MaryTennyson/Embaxus_Steno_Keyboard/docs/schematic.pdf

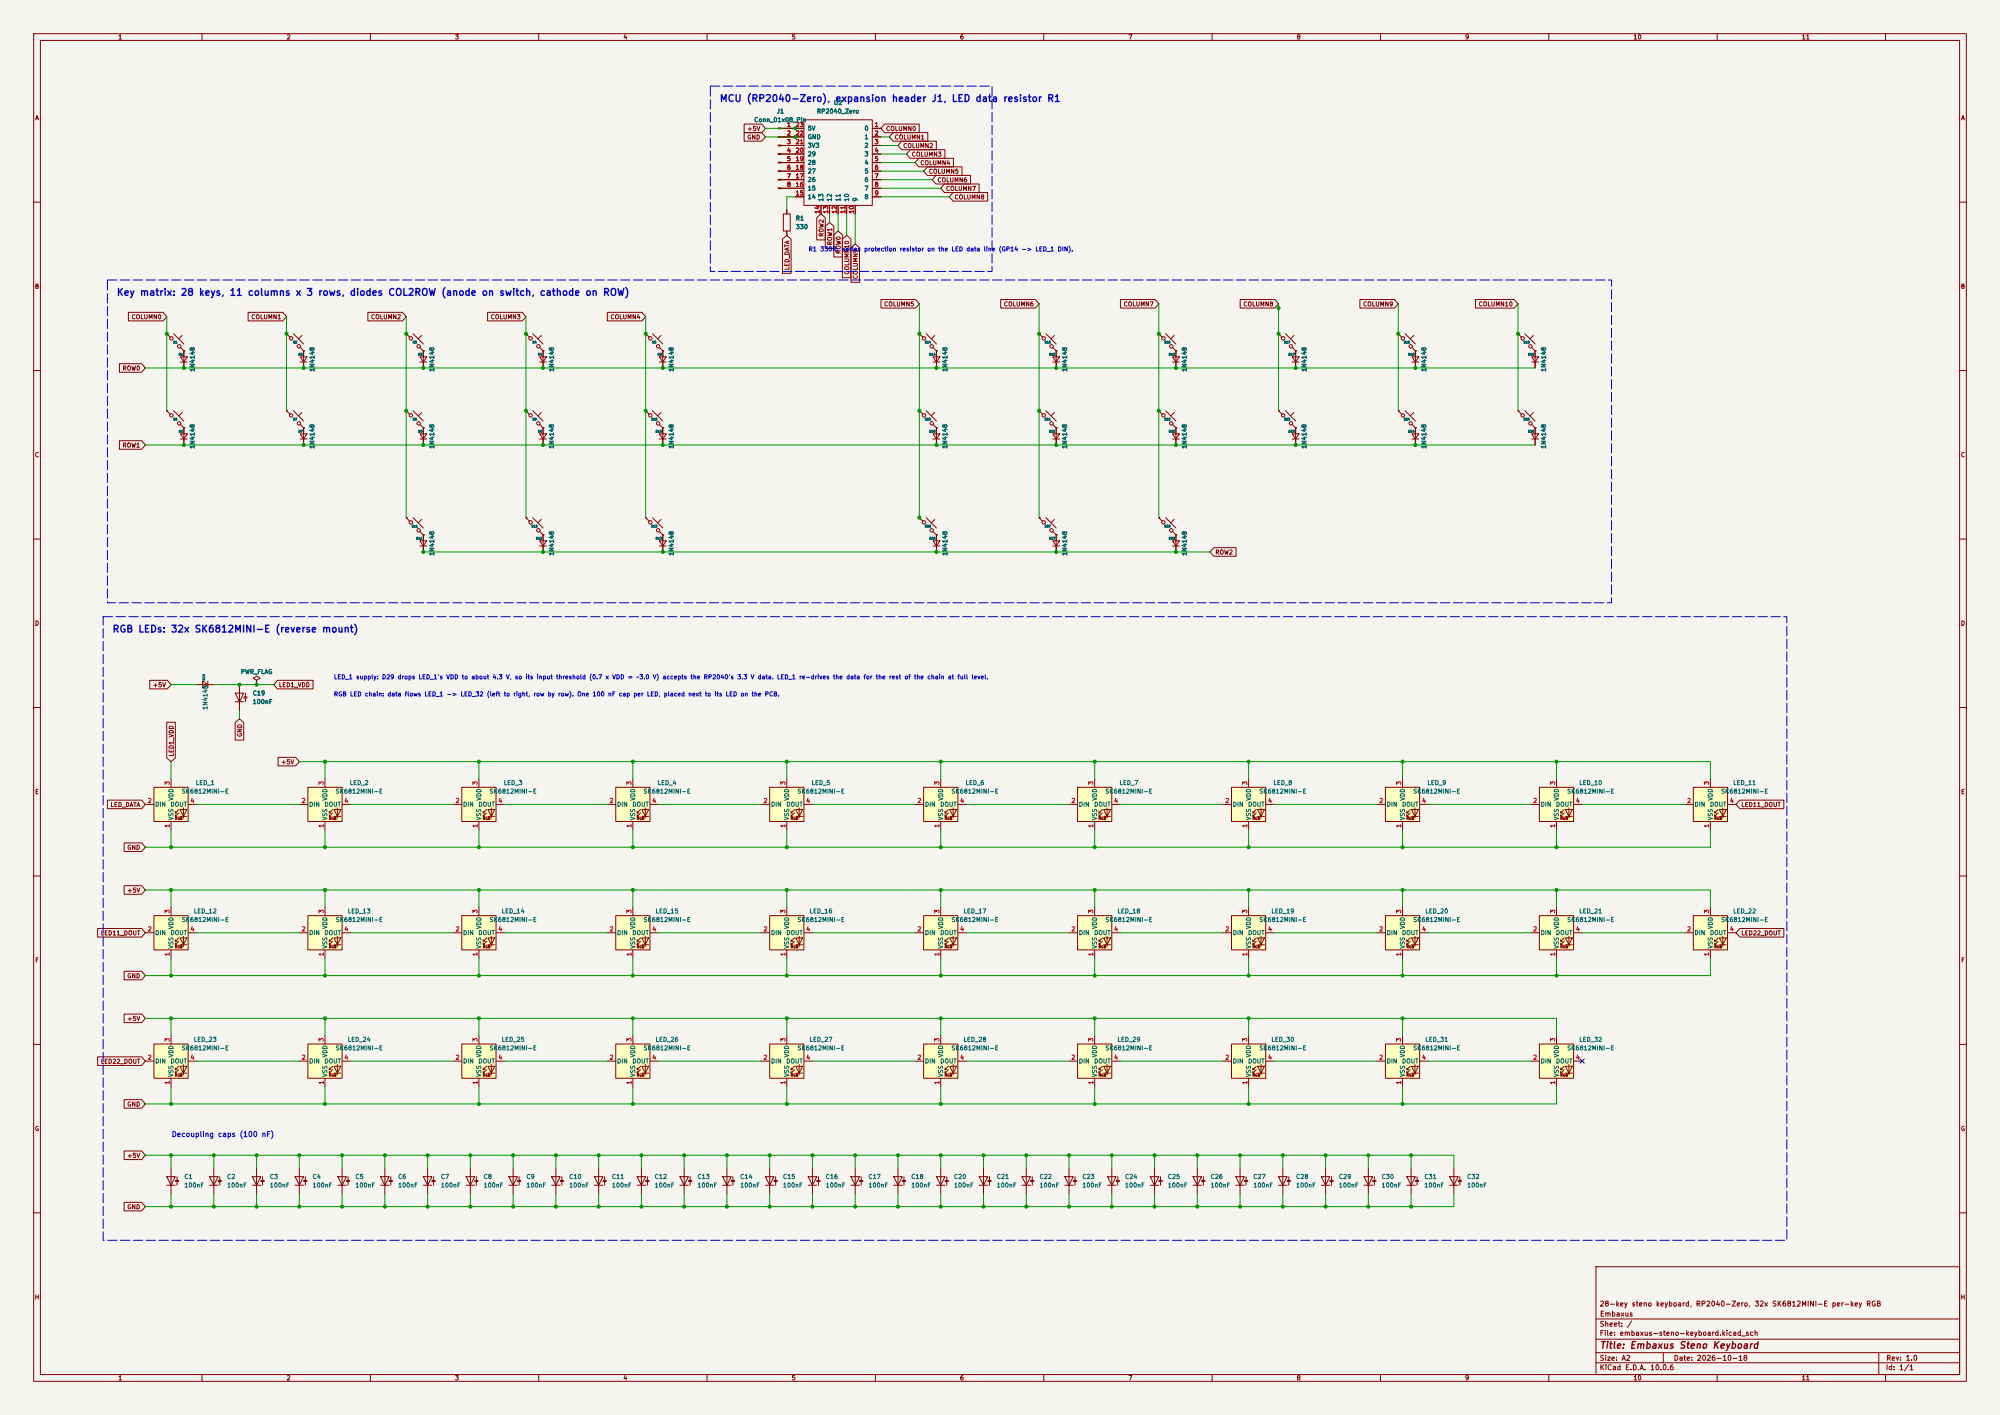
[picture p3: page 1]

COLUMN1 Key matrix: 28 keys, 11 columns x 3 rows, diodes COL2ROW (anode on switch, cathode on ROW)

R1 330R: series protection resistor on the LED data line (GP14 -> LED_1 DIN).

RGB LEDs: 32x SK6812MINI-E (reverse mount)

LED_1 supply: D29 drops LED_1's VDD to about 4.3 V, so its input threshold (0.7 x VDD = ~3.0 V) accepts the RP2040's 3.3 V data. LED_1 re-drives the data for the rest of the chain at full level. RGB LED chain: data flows LED_1 -> LED_32 (left to right, row by row). One 100 nF cap per LED, placed next to its LED on the PCB.

28-key steno keyboard, RP2040-Zero, 32x SK6812MINI-E per-key RGB
Embaxus
Sheet: /
File: embaxus-steno-keyboard.kicad_sch
Title: Embaxus Steno Keyboard

Size: A2 | Rev: 1.0
KiCad E.D.A. 10.0.6 | Id: 1/1
