MaryTennyson/Embaxus_Steno_Keyboard/hardware/embaxus-steno-keyboard.kicad_pcb

## KiCad design hardware/embaxus-steno-keyboard.kicad_pcb (2026-10-19)

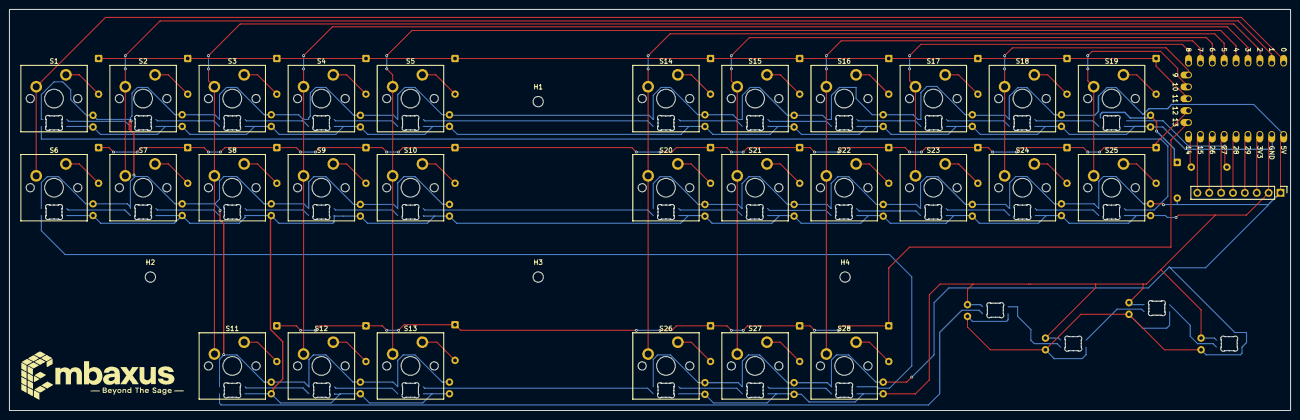
[picture p4: board embaxus-steno-keyboard.kicad_pcb from above]

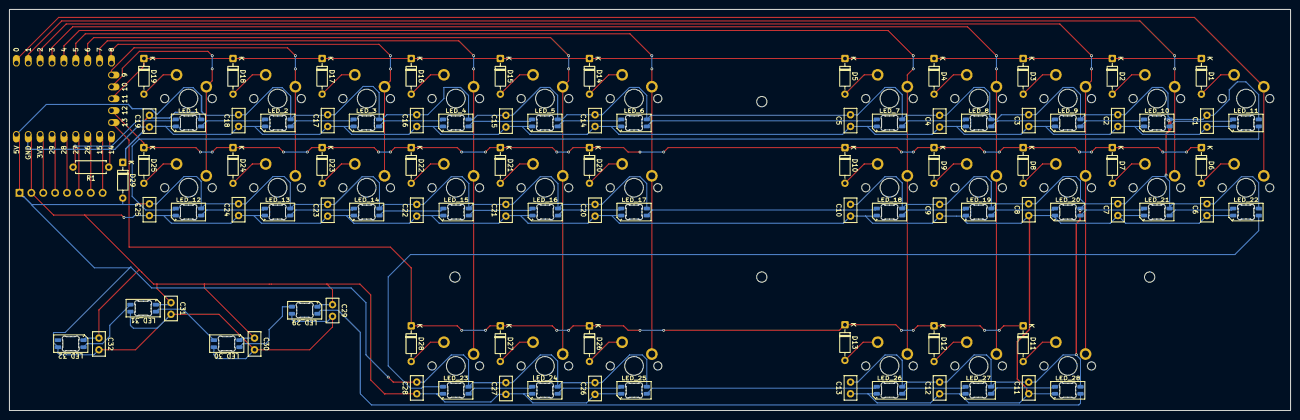
[picture p5: board embaxus-steno-keyboard.kicad_pcb from below]

Board: 2 copper layers, 273.8 x 85.7 mm, 128 parts (95 on the bottom side), 84 nets.

Parts:
C1, C2, C3, C4, C5, C6, C7, C8, C9, C10, C11, C12, C13, C14, C15, C16, C17, C18, C19, C20, C21, C22, C23, C24, C25, C26, C27, C28, C29, C30, C31, C32: 100nF; C_Disc_D5.0mm_W2.5mm_P2.50mm
D1, D2, D3, D4, D5, D6, D7, D8, D9, D10, D11, D12, D13, D14, D15, D16, D17, D18, D19, D20, D21, D22, D23, D24, D25, D26, D27, D28, D29: 1N4148; D_DO-35_SOD27_P7.62mm_Horizontal
H1, H2: M2; MountingHole_2.2mm_M2
H3: M3; MountingHole_2.2mm_M2
H4: M4; MountingHole_2.2mm_M2
J1: Conn_01x08_Pin; PinHeader_1x08_P2.54mm_Vertical
LED_1, LED_2, LED_3, LED_4, LED_5, LED_6, LED_7, LED_8, LED_9, LED_10, LED_11, LED_12, LED_13, LED_14, LED_15, LED_16, LED_17, LED_18, LED_19, LED_20, LED_21, LED_22, LED_23, LED_24, LED_25, LED_26, LED_27, LED_28, LED_29, LED_30, LED_31, LED_32: SK6812MINI-E; LED_SK6812MINI-E_3.2x2.8mm_P1.5mm_ReverseMount
R1: 330; R_Axial_DIN0207_L6.3mm_D2.5mm_P7.62mm_Horizontal
S1, S2, S3, S4, S5, S6, S7, S8, S9, S10, S11, S12, S13, S14, S15, S16, S17, S18, S19, S20, S21, S22, S23, S24, S25, S26, S27, S28: MX_PCB_1.00u
U2: RP2040_Zero

Connections:
+5V: C1.2 (A), C2.2 (A), C3.2 (A), C4.2 (A), C5.2 (A), C6.2 (A), C7.2 (A), C8.2 (A), C9.2 (A), C10.2 (A), C11.2 (A), C12.2 (A), C13.2 (A), C14.2 (A), C15.2 (A), C16.2 (A), C17.2 (A), C18.2 (A), C20.2 (A), C21.2 (A), C22.2 (A), C23.2 (A), C24.2 (A), C25.2 (A), C26.2 (A), C27.2 (A), C28.2 (A), C29.2 (A), C30.2 (A), C31.2 (A), C32.2 (A), D29.2 (A), J1.1, LED_2.3 (VDD), LED_3.3 (VDD), LED_4.3 (VDD), LED_5.3 (VDD), LED_6.3 (VDD), LED_7.3 (VDD), LED_8.3 (VDD), LED_9.3 (VDD), LED_10.3 (VDD), LED_11.3 (VDD), LED_12.3 (VDD), LED_13.3 (VDD), LED_14.3 (VDD), LED_15.3 (VDD), LED_16.3 (VDD), LED_17.3 (VDD), LED_18.3 (VDD), LED_19.3 (VDD), LED_20.3 (VDD), LED_21.3 (VDD), LED_22.3 (VDD), LED_23.3 (VDD), LED_24.3 (VDD), LED_25.3 (VDD), LED_26.3 (VDD), LED_27.3 (VDD), LED_28.3 (VDD), LED_29.3 (VDD), LED_30.3 (VDD), LED_31.3 (VDD), LED_32.3 (VDD), U2.23 (5V)
COLUMN0: S1.1, S6.1, U2.1 (0)
COLUMN1: S2.1, S7.1, U2.2 (1)
COLUMN2: S3.1, S8.1, S11.1, U2.3 (2)
COLUMN3: S4.1, S9.1, S12.1, U2.4 (3)
COLUMN4: S5.1, S10.1, S13.1, U2.5 (4)
COLUMN5: S14.1, S20.1, S26.1, U2.6 (5)
COLUMN6: S15.1, S21.1, S27.1, U2.7 (6)
COLUMN7: S16.1, S22.1, S28.1, U2.8 (7)
COLUMN8: S17.1, S23.1, U2.9 (8)
COLUMN9: S18.1, S24.1, U2.10 (9)
COLUMN10: S19.1, S25.1, U2.11 (10)
GND: C1.1 (K), C2.1 (K), C3.1 (K), C4.1 (K), C5.1 (K), C6.1 (K), C7.1 (K), C8.1 (K), C9.1 (K), C10.1 (K), C11.1 (K), C12.1 (K), C13.1 (K), C14.1 (K), C15.1 (K), C16.1 (K), C17.1 (K), C18.1 (K), C19.1 (K), C20.1 (K), C21.1 (K), C22.1 (K), C23.1 (K), C24.1 (K), C25.1 (K), C26.1 (K), C27.1 (K), C28.1 (K), C29.1 (K), C30.1 (K), C31.1 (K), C32.1 (K), J1.2, LED_1.1 (VSS), LED_2.1 (VSS), LED_3.1 (VSS), LED_4.1 (VSS), LED_5.1 (VSS), LED_6.1 (VSS), LED_7.1 (VSS), LED_8.1 (VSS), LED_9.1 (VSS), LED_10.1 (VSS), LED_11.1 (VSS), LED_12.1 (VSS), LED_13.1 (VSS), LED_14.1 (VSS), LED_15.1 (VSS), LED_16.1 (VSS), LED_17.1 (VSS), LED_18.1 (VSS), LED_19.1 (VSS), LED_20.1 (VSS), LED_21.1 (VSS), LED_22.1 (VSS), LED_23.1 (VSS), LED_24.1 (VSS), LED_25.1 (VSS), LED_26.1 (VSS), LED_27.1 (VSS), LED_28.1 (VSS), LED_29.1 (VSS), LED_30.1 (VSS), LED_31.1 (VSS), LED_32.1 (VSS), U2.22 (GND)
LED1_VDD: C19.2 (A), D29.1 (K), LED_1.3 (VDD)
LED11_DOUT: LED_11.4 (DOUT), LED_12.2 (DIN)
LED22_DOUT: LED_22.4 (DOUT), LED_23.2 (DIN)
LED_DATA: LED_1.2 (DIN), R1.2
unnamed: D1.2 (A), S1.2
unnamed: D2.2 (A), S2.2
unnamed: D3.2 (A), S3.2
unnamed: D4.2 (A), S4.2
unnamed: D5.2 (A), S5.2
unnamed: D6.2 (A), S6.2
unnamed: D7.2 (A), S7.2
unnamed: D8.2 (A), S8.2
unnamed: D9.2 (A), S9.2
unnamed: D10.2 (A), S10.2
unnamed: D11.2 (A), S11.2
unnamed: D12.2 (A), S12.2
unnamed: D13.2 (A), S13.2
unnamed: D14.2 (A), S14.2
unnamed: D15.2 (A), S15.2
unnamed: D16.2 (A), S16.2
unnamed: D17.2 (A), S17.2
unnamed: D18.2 (A), S18.2
unnamed: D19.2 (A), S19.2
unnamed: D20.2 (A), S20.2
unnamed: D21.2 (A), S21.2
unnamed: D22.2 (A), S22.2
unnamed: D23.2 (A), S23.2
unnamed: D24.2 (A), S24.2
unnamed: D25.2 (A), S25.2
unnamed: D26.2 (A), S26.2
unnamed: D27.2 (A), S27.2
unnamed: D28.2 (A), S28.2
unnamed: J1.3, U2.21 (3V3)
unnamed: J1.4, U2.20 (29)
unnamed: J1.5, U2.19 (28)
unnamed: J1.6, U2.18 (27)
unnamed: J1.7, U2.17 (26)
unnamed: J1.8, U2.16 (15)
unnamed: LED_1.4 (DOUT), LED_2.2 (DIN)
unnamed: LED_2.4 (DOUT), LED_3.2 (DIN)
unnamed: LED_3.4 (DOUT), LED_4.2 (DIN)
unnamed: LED_4.4 (DOUT), LED_5.2 (DIN)
unnamed: LED_5.4 (DOUT), LED_6.2 (DIN)
unnamed: LED_6.4 (DOUT), LED_7.2 (DIN)
unnamed: LED_7.4 (DOUT), LED_8.2 (DIN)
unnamed: LED_8.4 (DOUT), LED_9.2 (DIN)
unnamed: LED_9.4 (DOUT), LED_10.2 (DIN)
unnamed: LED_10.4 (DOUT), LED_11.2 (DIN)
unnamed: LED_12.4 (DOUT), LED_13.2 (DIN)
unnamed: LED_13.4 (DOUT), LED_14.2 (DIN)
unnamed: LED_14.4 (DOUT), LED_15.2 (DIN)
unnamed: LED_15.4 (DOUT), LED_16.2 (DIN)
unnamed: LED_16.4 (DOUT), LED_17.2 (DIN)
unnamed: LED_17.4 (DOUT), LED_18.2 (DIN)
unnamed: LED_18.4 (DOUT), LED_19.2 (DIN)
unnamed: LED_19.4 (DOUT), LED_20.2 (DIN)
unnamed: LED_20.4 (DOUT), LED_21.2 (DIN)
unnamed: LED_21.4 (DOUT), LED_22.2 (DIN)
unnamed: LED_23.4 (DOUT), LED_24.2 (DIN)
unnamed: LED_24.4 (DOUT), LED_25.2 (DIN)
unnamed: LED_25.4 (DOUT), LED_26.2 (DIN)
unnamed: LED_26.4 (DOUT), LED_27.2 (DIN)
unnamed: LED_27.4 (DOUT), LED_28.2 (DIN)
unnamed: LED_28.4 (DOUT), LED_29.2 (DIN)
unnamed: LED_29.4 (DOUT), LED_30.2 (DIN)
unnamed: LED_30.4 (DOUT), LED_31.2 (DIN)
unnamed: LED_31.4 (DOUT), LED_32.2 (DIN)
unnamed: R1.1, U2.15 (14)
ROW0: D1.1 (K), D2.1 (K), D3.1 (K), D4.1 (K), D5.1 (K), D14.1 (K), D15.1 (K), D16.1 (K), D17.1 (K), D18.1 (K), D19.1 (K), U2.12 (11)
ROW1: D6.1 (K), D7.1 (K), D8.1 (K), D9.1 (K), D10.1 (K), D20.1 (K), D21.1 (K), D22.1 (K), D23.1 (K), D24.1 (K), D25.1 (K), U2.13 (12)
ROW2: D11.1 (K), D12.1 (K), D13.1 (K), D26.1 (K), D27.1 (K), D28.1 (K), U2.14 (13)
